ElectronicCats/MeowMeow/Recursos/led.png

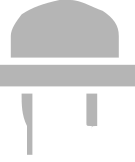
Recursos/led.png
