ElectronicCats/MeowMeow/Recursos/Meow Meow_graphics.png

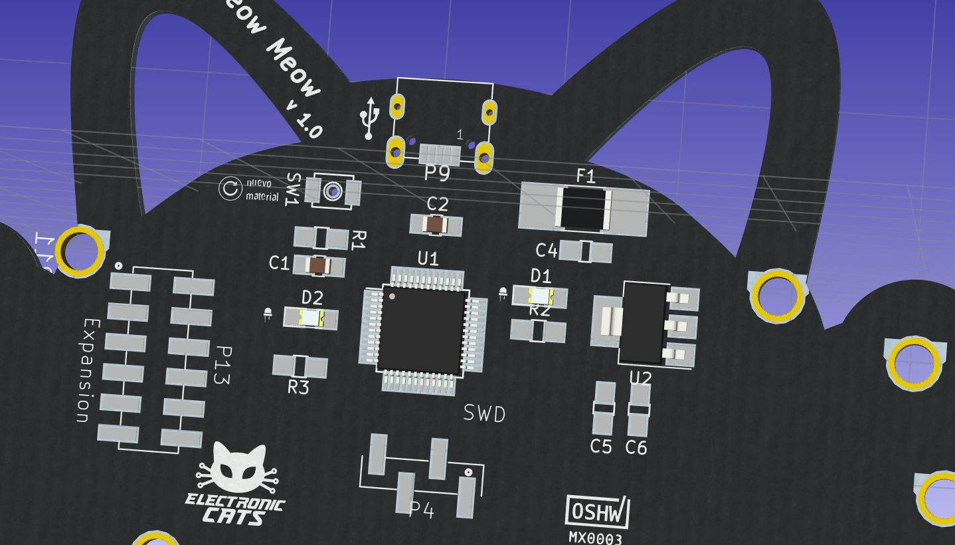
Recursos/Meow Meow_graphics.png
