ElectronicCats/MeowMeow/Recursos/meow_meow.png

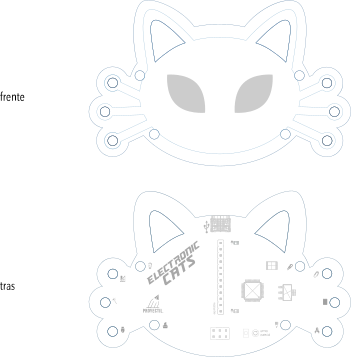
Recursos/meow_meow.png
