ElectronicCats/MeowMeow/Recursos/nuevomaterial.png

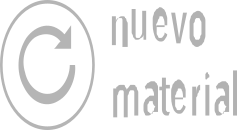
Recursos/nuevomaterial.png
