ElectronicCats/MeowMeow/3D/User Library-OMRON B3U1000P.STEP

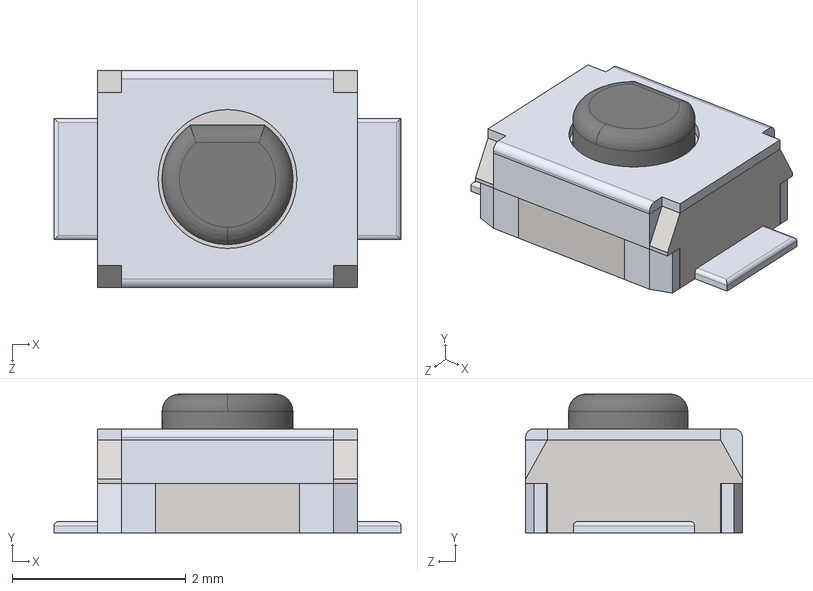
[picture p6: CAD file, 2018-08-22]
3D/User Library-OMRON B3U1000P.STEP
4.00 x 1.60 x 2.50 mm
