ElectronicCats/MeowMeow/(threads)

Thread 23 (2025-06-02):

v1.1 No conecta en windows 11

Alextinto, 2025-06-02:
Hola, tengo un meowmeow versión v1.1. Intente conectarlo a windows 11, pero pareciera que ni siquiera es detectado por el administrador de dispositivos, igualmente intente entrar al modo reset y tampoco aparece como dispositivo de almacenamiento.

Closed 2025-06-05.
