ElectronicCats/MeowMeow/hardware/Meow_Meow_schematic.pdf

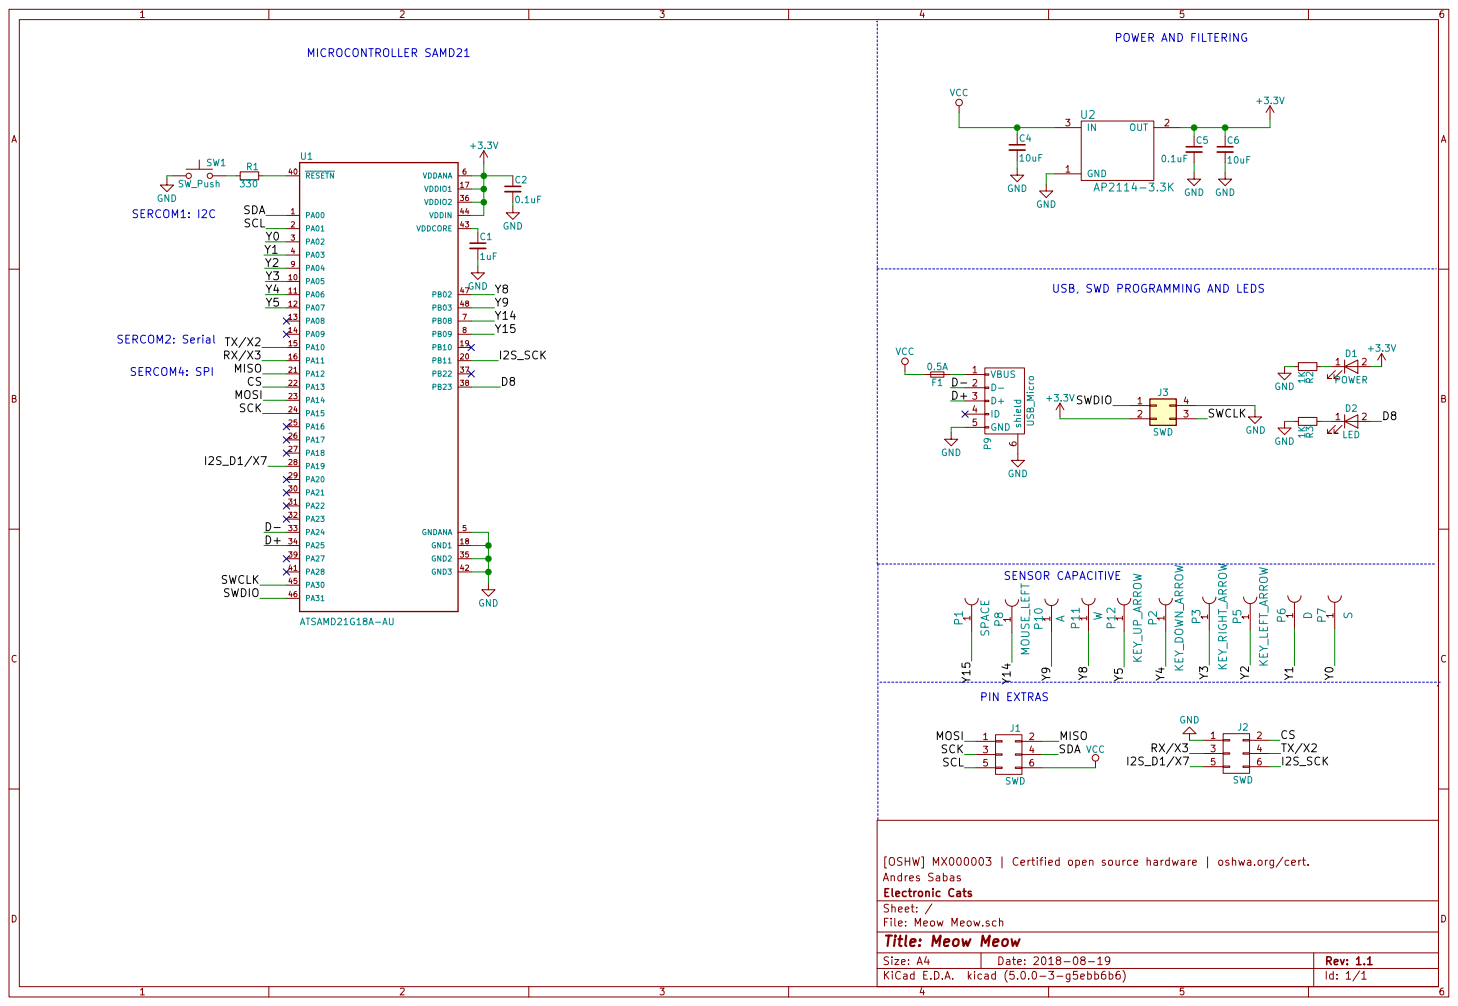
[picture p8: page 1]

+3.3V GND GND GND Y3 SWCLK

USB, SWD PROGRAMMING AND LEDS

[OSHW] MX000003 | Certified open source hardware | oshwa.org/cert.
File: Meow Meow.sch Sheet: / Electronic Cats Andres Sabas

Id: 1/1 Title: Meow Meow
