ElectronicCats/MeowMeow/hardware/Meow Meow.kicad_pcb

## KiCad design hardware/Meow Meow.kicad_pcb (2018-06-11)

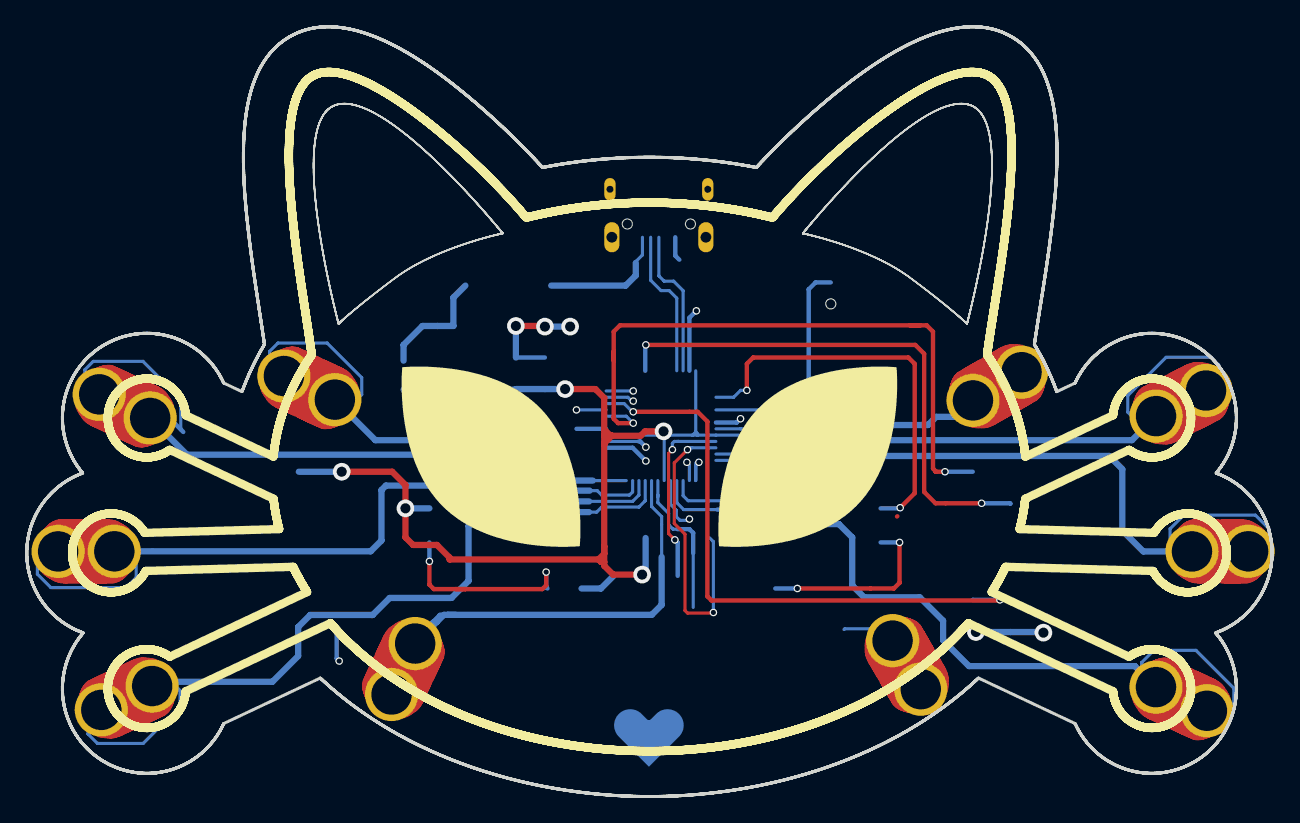
[picture p9: board Meow Meow.kicad_pcb from above]

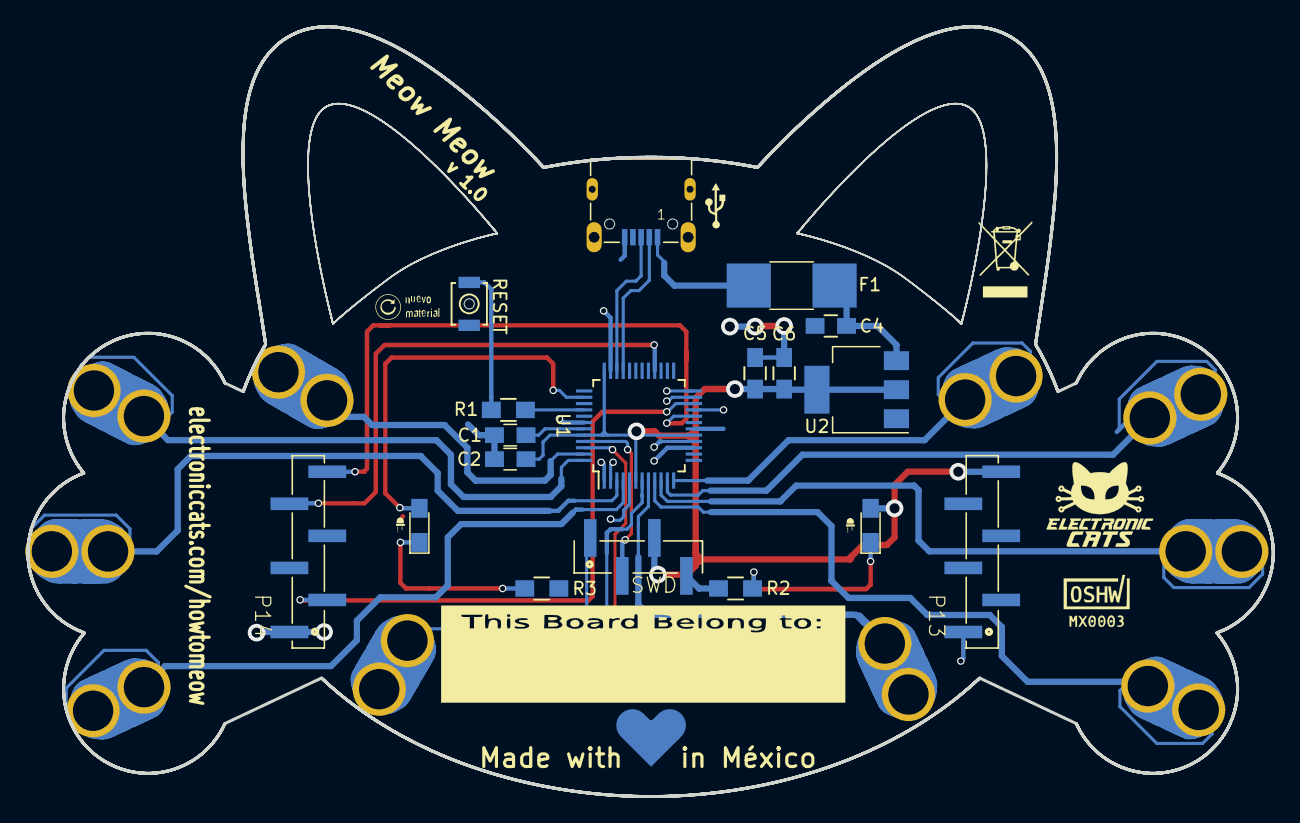
[picture p10: board Meow Meow.kicad_pcb from below]

Board: 2 copper layers, 98.7 x 61.0 mm, 34 parts (23 on the bottom side), 34 nets.

Parts:
C1: 1uF; C_0805_HandSoldering
C2, C5: 0.1uF; C_0805_HandSoldering
C4, C6: 10uF; C_0805_HandSoldering
D1: POWER; LED_0805_HandSoldering
D2: LED; LED_0805_HandSoldering
F1: 0.5A; R_1812_HandSoldering
P1: D; SEWALLI_renew
P2: SPACE; SEWALLI_renew
P3: KEY_RIGHT_ARROW; SEWALLI_renew
P4: SWD; 61000418321
P5: KEY_LEFT_ARROW; SEWALLI_renew
P6: KEY_DOWN_ARROW; SEWALLI_renew
P7: KEY_UP_ARROW; SEWALLI_renew
P8: S; SEWALLI_renew
P9: USB_Micro; 629105150521
P10: A; SEWALLI_renew
P11: W; SEWALLI_renew
P12: MOUSE_LEFT; SEWALLI_renew
P13, P14: CONN_01X06; 61000618321
R1: 330; R_0805_HandSoldering
R2, R3: 1K; R_0805_HandSoldering
RESET: SW_Push; SW_SPST_B3U-1000P-B
U1: ATSAMD21G18A-AU; TQFP-48_7x7mm_Pitch0.5mm
U2: AP2114-3.3K; SOT-223-3Lead_TabPin2
svg2mod: meowmeow; svg2mod
svg2mod#2, svg2mod#3, svg2mod#4, svg2mod#5, svg2mod#6: G***; svg2mod

Connections:
+3V3: C2.1, C5.1, C6.1, D1.2, P4.3, P13.6, U1.6, U1.17, U1.36, U1.44, U2.2
/CS: P14.2, U1.22
/D8: D2.2, U1.38
/D+: P9.3, U1.34
/D-: P9.2, U1.33
/I2S_D1/X7: P14.5, U1.28
/I2S_SCK: P14.6, U1.20
/MISO: P13.2, U1.21
/MOSI: P13.1, U1.23
/RX/X3: P14.3, U1.16
/SCK: P13.3, U1.24
/SCL: P13.5, U1.2
/SDA: P13.4, U1.1
/SWCLK: P4.2, U1.45
/SWDIO: P4.1, U1.46
/TX/X2: P14.4, U1.15
/Y0: P7.1, U1.3
/Y1: P6.1, U1.4
/Y2: P5.1, U1.9
/Y3: P3.1, U1.10
/Y4: P2.1, U1.11
/Y5: P12.1, U1.12
/Y8: P11.1, U1.47
/Y9: P10.1, U1.48
/Y14: P8.1, U1.7
/Y15: P1.1, U1.8
GND: C1.2, C2.2, C4.2, C5.2, C6.2, P4.4, P9.5, P14.1, R2.2, R3.2, RESET.1, U1.5, U1.18, U1.35, U1.42, U2.1
unnamed: C1.1, U1.43
unnamed: D1.1, R2.1
unnamed: D2.1, R3.1
unnamed: F1.2, P9.1
unnamed: R1.1, RESET.2
unnamed: R1.2, U1.40
VCC: C4.1, F1.1, U2.3
