ElectronicCats/MeowMeow/(commit log)

2018-04-20 Schematic 0.1 alpha
    [Meow Meow.kicad_pcb, Meow Meow.sch]
2018-04-27 Remove button reset
    [Meow Meow.sch]
2018-04-27 Init PCB
    [Meow Meow.kicad_pcb]
2018-04-27 Add library for schematic
    [Meow Meow.sch]
2018-04-28 Update sch library
    [Meow Meow.sch]
2018-04-28 change uC
    [Meow Meow.sch]
2018-04-28 Add footprint library
2018-04-30 Fix conections
    [Meow Meow.sch]
2018-05-01 PCB V1
    [Meow Meow.kicad_pcb, Meow Meow.sch]
2018-05-01 check pcb
    [Meow Meow.kicad_pcb]
2018-05-16 Version SAMD21
    [Meow Meow.sch]
2018-05-16 Add I2C, I2S, Serial and SPI port
    [Meow Meow.sch]
2018-05-16 Fix label name pins X
    [Meow Meow.sch]
2018-05-17 Fix logic activation button
    [MeowMeow.ino]
2018-05-18 Rename pin with firmware beta and extra pins
    [Meow Meow.sch]
2018-05-22 Added Initial Calibration
2018-05-24 Update netlist samd21
    [Meow Meow.sch]
2018-05-24 Update componets
    [Meow Meow.kicad_pcb]
2018-05-25 Change calibration metod
2018-05-25 Update capacitor Vddcore and leds
    [Meow Meow.kicad_pcb, Meow Meow.sch]
2018-05-30 Update BOM
    [Meow Meow.sch]
2018-06-07 Add figure
    [Meow Meow.kicad_pcb]
2018-06-07 Change Headers Expansion and SWD
    [Meow Meow.sch]
2018-06-07 Update PCB
    [Meow Meow.kicad_pcb]
2018-06-09 PCB update
    [Meow Meow.kicad_pcb, _saved_Meow Meow.sch]
2018-06-11 added new connector
    [Meow Meow.kicad_pcb, Meow Meow.sch, _saved_Meow Meow.sch]
2018-06-11 Add logos
    [Meow Meow.kicad_pcb, Meow Meow.sch]
2018-06-11 place components to route
    [Meow Meow.kicad_pcb]
2018-06-11 Start routing
    [Meow Meow.kicad_pcb]
2018-06-11 Change eyes to Silks
    [Meow Meow.kicad_pcb]
2018-06-12 All traces complete
2018-06-19 Add pin 5v
    [Meow Meow.sch]
2018-06-19 Firmware default v0.5 beta
    Firmware for restore device
2018-06-28 Update default bootloader with new PID and VID USB and uf2
2018-07-25 connector 6 pin
    se quito 3V
    [Meow Meow.sch]
2018-07-25 SENSOR CAPACITIVE
    [Meow Meow.sch]
2018-07-25 Footprit new connectors
    [Meow Meow.sch, _saved_Meow Meow.sch]
2018-07-27 Footprint connector 2x2
    [Meow Meow.sch, _saved_Meow Meow.sch]
2018-08-16 Routeo new connectors
2018-08-16 Reacomodo de vias
2018-08-17 Plano GND back
2018-08-20 Pre-version 1.0
    [Meow Meow.sch]
2018-08-21 3D USB
    [629105150521 (rev1).stp, Meow Meow.sch]
2018-08-22 3D botton
    [Meow Meow-2018-08-22-12-05-13.sch, User Library-OMRON B3U1000P.STEP]
2018-09-10 Botton reset
    [Meow Meow-2018-09-10-11-49-35.sch]
2018-09-18 components meowmeow.lib kicad5
    [Meow Meow-2018-09-17-22-53-36.sch, Meow Meow.sch]
2018-09-24 Modificacion Drill de conector USB
2018-09-24 GND PLANE
2018-10-05 Update pin to version 1.1
2018-12-25 update files to v1.1
    [Meow Meow.sch]
2018-12-25 update bootloader arduino ide
2019-01-02 change connectors schematic
    [Meow Meow.sch]
2019-03-30 remove unnecessary
    [Meow Meow-2018-08-22-12-05-13.sch, Meow Meow-2018-09-10-11-49-35.sch, Meow Meow-2018-09-17-22-53-36.sch]
2019-03-30 update files
    [Meow Meow.sch]
2019-04-01 revert value resistor
2019-04-01 best comments error in QT sensors
    [MeowMeow.ino]
2019-04-02 change reset button
    [Meow Meow.sch]
2020-02-15 update schematic headers feather
    [Meow Meow.sch]
2020-02-15 update footprints
2020-02-15 clean pcb
    [Meow Meow.kicad_pcb]
2021-06-21 update pinout and simbol
    [Meow Meow.kicad_pcb, Meow Meow.sch]
2021-06-21 change GPIO13
    [Meow Meow.sch]
2021-06-22 New floorplant
    [Meow Meow.sch]
2021-06-23 Finished new routing
    [Meow Meow.sch]
2021-06-23 Fixed Labels and changed LDO
    [Meow Meow.sch]
2021-06-23 modify caps
    [Meow Meow.sch]
2021-06-24 update wing
    [Meow Meow.sch]
2022-01-20 Update Kicad 6
2022-01-21 add firmware test wing leds
2022-01-21 add binary files wing led test
2022-03-30 change to SAML21G
    [Meow Meow.kicad_sch]
2022-04-15 update layout
    [Meow Meow.kicad_sch]
2022-04-27 update version
    [Meow Meow.kicad_sch]
2022-05-30 update USB connector v3.1
    [Meow Meow.kicad_sch]
2022-07-04 Updated 3.1V BOM and added "HTML" and "Pos" archives
2022-07-15 Fix pins capacitive
    [Meow Meow.kicad_sch]
2022-07-16 update layout and fix pins 3.2v
    [Meow Meow.kicad_sch]
2022-07-16 fix layou erase previous files
    [Meow Meow.sch]
2022-08-23 Update README.md
    Se dejo mas claro donde podia encontrar el Manual
2022-08-26 fixed error calibration
2022-08-29 fix calibrate for Meow Meow 1
    [MeowMeow.ino]
2022-08-29 fix calibrate for meow meow 2
    [MeowMeow2.ino]
2023-11-28 Actualizacion README
    Se agregó links a la wiki, imágenes referentes y algunas correcciones.
2023-12-06 Update wiki pic
    Nueva imagen para la wiki que faltaba
2023-12-26 Actualizacion readme
    Cambio boton tienda y Wiki. Se corrigio error de imagen.
